Breezedude/breezedudeWindSensor-pcb/README.md

# breezedudeWindSensor-pcb
PCB of Breezedude Wind Sensor Transmitter
