Breezedude/breezedudeWindSensor-pcb/transmitter/breezedude_transmitter.kicad_pcb

## KiCad design transmitter/breezedude_transmitter.kicad_pcb (2026-10-22)

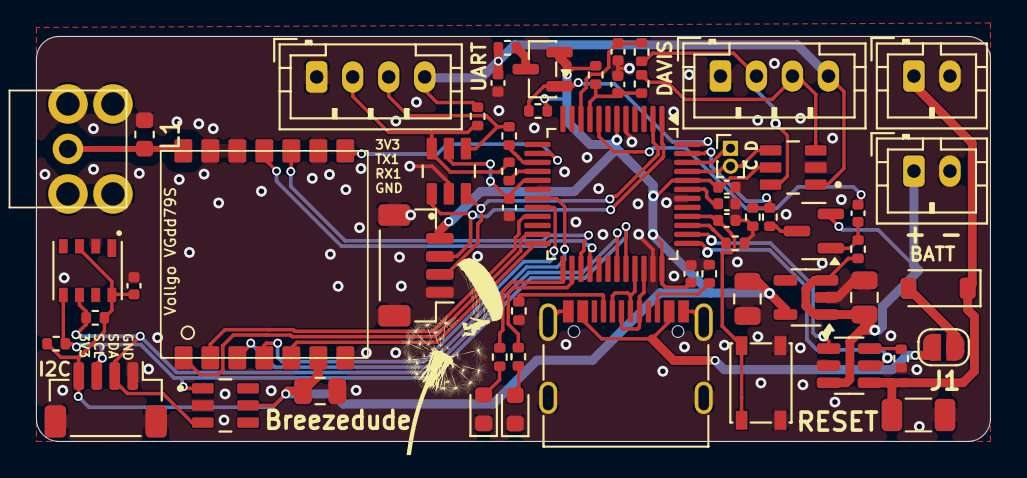
[picture p1: board breezedude_transmitter.kicad_pcb from above]

Board: 2 copper layers, 53.0 x 22.5 mm, 59 parts (1 on the bottom side), 50 nets.

Parts:
AE1: Antenna_Shield; sma_edge_6.5mm_vert
BT1: 1050; BAT_1050
C1: 47u 10V; C_1206_3216Metric
C2, C6, C8: 10u 6.3V; C_0402_1005Metric
C3, C4, C12: 47u 6.3V; C_0805_2012Metric
C5, C9, C10, C11, C13, C14: 100n 16V; C_0402_1005Metric
C7: 10n 16V; C_0402_1005Metric
D3: LED blue; LED_0603_1608Metric
D4: LED red; LED_0603_1608Metric
D5: Diode; D_SOD-123
J1, J6: Conn_01x02_Pin; JST_PH_B2B-PH-K_1x02_P2.00mm_Vertical
J2, J11: Conn_01x04_Pin; JST_SH_BM04B-SRSS-TB_1x04-1MP_P1.00mm_Vertical
J3, J5: Conn_01x04_Pin; JST_PH_B4B-PH-K_1x04_P2.00mm_Vertical
J7: USB_C_Receptacle_USB2.0_16P; USB_C_Receptacle_G-Switch_GT-USB-7010ASV
J8: Conn_01x02_Pin; PinHeader_1x02_P1.00mm_Vertical
JP1: SolderJumper_2_Open; SolderJumper-2_P1.3mm_Open_RoundedPad1.0x1.5mm
L1: 68nH; L_0603_1608Metric
Q2, Q3: P-MOS; SOT-23
R1, R3, R12: 10k; R_0402_1005Metric
R2, R5: 100k; R_0402_1005Metric
R4: 330k; R_0402_1005Metric
R6: 470; R_0402_1005Metric
R7: 200; R_0402_1005Metric
R8, R9: 3.3k; R_0402_1005Metric
R10, R11: 5.1k; R_0402_1005Metric
R13, R19: 4k7; R_0402_1005Metric
R14, R16, R17: 22R; R_0402_1005Metric
R15: 1k; R_0402_1005Metric
R18: 1M5; R_0402_1005Metric
SW1: SW_Push; SW_SPST_PTS810
U1, U10, U11: D1213A-04TS-7; SOT95P280X140-6N
U2: STLQ015M33R; SOT-23-5
U3: ATSAMD21G18A-A; TQFP-48_7x7mm_P0.5mm
U6: vollgo_vgdd79s868n0s1
U8: HP203B; HP203B-LGA8
U9: TP4057; TSOT-23-6

Connections:
3V3: C4.2, C6.2, C8.2, C10.2, C12.2, C14.2, J2.4, J11.4, Q3.2 (S), R2.1, R8.2, R9.2, R18.2, U1.5 (VP), U2.5 (VOUT), U3.6 (VDDANA), U3.17 (VDDIO), U3.36 (VDDIO), U3.44 (VDDIN), U6.6 (VCC), U8.3 (VDD), U8.8 (CSB), U10.5 (VP), U11.5 (VP)
/ANT: AE1.1 (A), L1.2, U6.14 (ANT)
/BATT+: BT1.P, C3.2, J1.1, Q2.2 (S), R3.1, U2.1 (VIN), U2.3 (EN), U9.3 (BAT)
/DAVIS_DIR: J3.2, R13.1, U1.6 (IO4)
/DAVIS_DIR_FILT: C7.2, R13.2, U3.10 (PA05)
/DAVIS_SPEED: J3.3, R15.2, U1.3 (IO2)
/DAVIS_SPEED_FILT: C5.1, R2.2, R15.1, U3.9 (PA04)
/HW_Ver1: R19.1, U3.39 (PA27)
/LED1: R6.1, U3.26 (PA17)
/LED2: R7.1, U3.25 (PA16)
/LORA_CS: U3.24 (PA15), U6.5 (CS)
/LORA_DIO1: U3.27 (PA18), U6.10 (DIO1)
/LORA_DIO2: U3.28 (PA19), U6.11 (BUSY)
/LORA_DIO3: U3.14 (PA09), U6.8 (DIO3)
/LORA_MISO: U3.21 (PA12), U6.2 (MISO)
/LORA_MOSI: U3.19 (PB10), U6.3 (MOSI)
/LORA_RESET: U3.23 (PA14), U6.1 (RST)
/LORA_SCK: U3.20 (PB11), U6.4 (SCK)
/PV_CHARGE: U3.38 (PB23), U9.1 (~CHRG)
/PV_DONE: U3.37 (PB22), U9.5 (STDBY)
/RESET: C11.2, SW1.1, U3.40 (~RESET)
/RX: J5.2, R12.1, R17.2, U11.6 (IO4)
/RX1: J11.2, U3.2 (PA01), U11.3 (IO2)
/SCL: J2.3, R8.1, U3.32 (PA23), U8.5 (SCL), U10.1 (IO1)
/SDA: J2.2, R9.1, U3.31 (PA22), U8.6 (SDA), U10.3 (IO2)
/SOLAR+: C1.2, D5.1 (K), J6.1, U9.4 (V_{CC})
/SWDCLK: J8.2, U1.4 (IO3), U3.45 (PA30)
/SWDIO: J8.1, U3.46 (PA31)
/SW_SENSOR: Q3.1 (G), R18.1, U3.48 (PB03)
/TX: J5.3, R16.2, U11.4 (IO3)
/TX1: J11.3, U3.1 (PA00), U11.1 (IO1)
/USB_N: J7.A7 (D-), J7.B7 (D-), U3.33 (PA24)
/USB_P: J7.A6 (D+), J7.B6 (D+), U3.34 (PA25)
/VCC_SENSOR: C13.2, J3.4, J5.4, R12.2, R14.1, U1.1 (IO1)
/V_DIV: R4.2, R5.1, U3.47 (PB02)
/V_IMP: C9.2, U3.8 (PB09)
GND: AE1.2 (Shield), BT1.N, C1.1, C2.1, C3.1, C4.1, C5.2, C6.1, C7.1, C8.1, C10.1, C11.1, C12.1, C13.1, C14.1, D3.1 (K), D4.1 (K), J1.2, J2.1, J2.MP (MountPin), J3.1, J5.1, J6.2, J7.A1 (GND), J7.A12 (GND), J7.B1 (GND), J7.B12 (GND), J7.S1 (SHIELD), J11.1, J11.MP (MountPin), L1.1, R1.2, R5.2, R10.2, R11.2, R19.2, SW1.2, U1.2 (VN), U2.2 (GND), U3.5 (GNDANA), U3.18 (GND), U3.35 (GND), U3.42 (GND), U6.7 (GND), U6.9 (GND), U6.12 (GND), U6.13 (GND), U8.2 (GND), U9.2 (GND), U10.2 (VN), U11.2 (VN)
unnamed: D3.2 (A), R6.2
unnamed: D4.2 (A), R7.2
unnamed: D5.2 (A), JP1.2 (B)
unnamed: J7.A5 (CC1), R10.1
unnamed: J7.B5 (CC2), R11.1
unnamed: J7.A4 (VBUS), J7.A9 (VBUS), J7.B4 (VBUS), J7.B9 (VBUS), JP1.1 (A)
unnamed: Q2.3 (D), R4.1
unnamed: C9.1, Q2.1 (G), R3.2
unnamed: Q3.3 (D), R14.2
unnamed: R16.1, U3.15 (PA10)
unnamed: R17.1, U3.16 (PA11)
unnamed: C2.2, U3.43 (VDDCORE)
unnamed: R1.1, U9.6 (PROG)
