Breezedude/breezedudeWindSensor-pcb/protection_board/protection_board.kicad_pcb

## KiCad design protection_board/protection_board.kicad_pcb (2026-06-05)

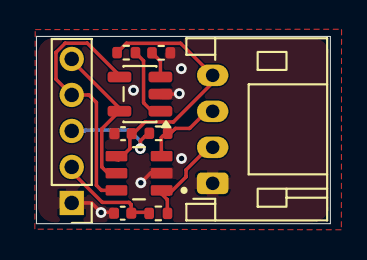
[picture p2: board protection_board.kicad_pcb from above]

Board: 2 copper layers, 16.3 x 10.4 mm, 10 parts (0 on the bottom side), 10 nets.

Parts:
C7: 10n 16V; C_0402_1005Metric
C14: 100n 16V; C_0402_1005Metric
J3: Conn_01x04_Pin; JST_PH_S4B-PH-K_1x04_P2.00mm_Horizontal
J4: Conn_01x05_Pin; PinHeader_1x05_P2.00mm_Vertical
R13: 4.7k; R_0402_1005Metric
R15: 1k; R_0402_1005Metric
R16: 22R; R_0402_1005Metric
R17: 68k; R_0402_1005Metric
U1: AAT4610BIGV-1-T1; SOT-23-5
U2: D1213A-04TS-7; SOT95P280X140-6N

Connections:
/3V3: J4.5, U1.5 (IN), U2.5 (VP)
/DAVIS_DIR: J3.2, R13.1, U2.1 (IO1)
/DAVIS_DIR_FILT: C7.2, J4.2, R13.2
/DAVIS_SPEED: J3.3, R15.2, U2.3 (IO2)
/DAVIS_SPEED_FILT: J4.3, R15.1
/SW_POW: J4.4, U1.4 (ON), U2.6 (IO4)
/VCC_SENSOR: C14.2, J3.4, R16.1, U2.4 (IO3)
GND: C7.1, C14.1, J3.1, J4.1, R17.1, U1.2 (GND), U2.2 (VN)
unnamed: R16.2, U1.1 (OUT)
unnamed: R17.2, U1.3 (SET)
