Breezedude/breezedudeWindSensor-pcb/(commit log)

2026-06-05 V2.4 - see changelog
    [breezedude_transmitter.kicad_pcb, breezedude_transmitter.kicad_sch, protection_board.kicad_pcb, protection_board.kicad_sch]
2026-10-22 V2.5 - some pin changes and improvements. Requires FW 1.2.0+
    [breezedude_transmitter.kicad_pcb, breezedude_transmitter.kicad_sch]
