Breezedude/breezedudeWindSensor-pcb/(notices)

Notices in the files:
transmitter/breezedude_transmitter.kicad_pcb:
© Breezedude
